Dallas-Makerspace/ThrICE-Access-Control/README

All schematics and circuit board designs are licensed under a Creative Commons Attribution-ShareAlike 3.0 Unported License.
