Dallas-Makerspace/ThrICE-Access-Control/threshold_control_device_smd.brd

## EAGLE design threshold_control_device_smd.brd (2012-08-05)

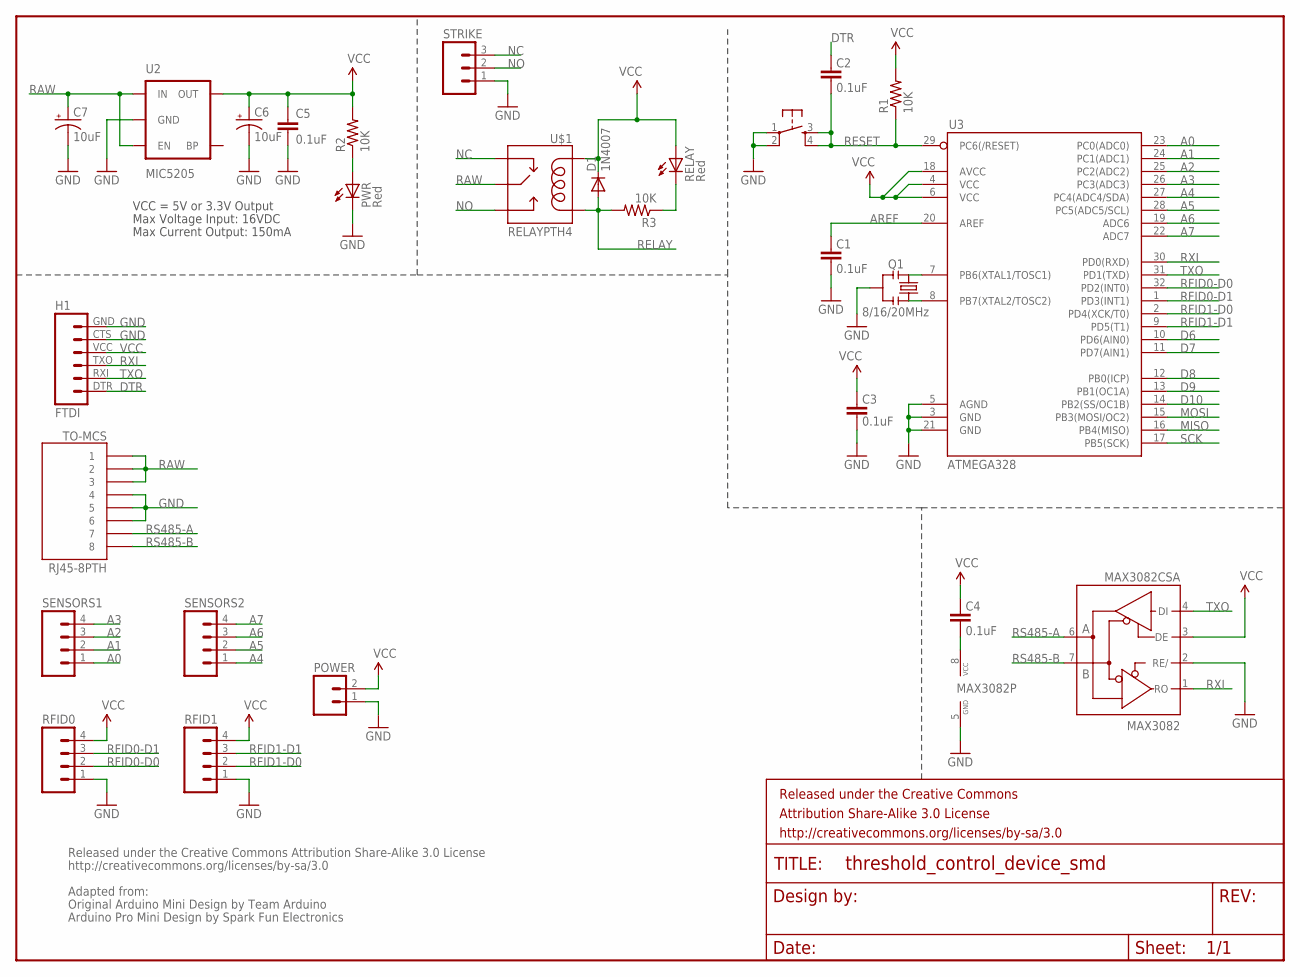
[picture p1: schematic threshold_control_device_smd.sch]

Parts:
C1, C2, C3, C4, C5: 0.1uF; 0402-CAP
C6, C7: 10uF; EIA3216
D1: 1N4007; SMA-DIODE
FRAME1: FRAME-LETTER; CREATIVE_COMMONS
H1: FTDI; FTDI_BASIC
MAX3082: MAX3082CSA; SO08
POWER: M023.5MM; SCREWTERMINAL-3.5MM-2
PWR: Red; LED-0603
Q1: 8/16/20MHz; RESONATOR-SMD
R1, R2, R3: 10K; 0402-RES
RELAY: Red; LED-0603
RESET: Reset; TACTILE_SWITCH_SMD
RFID0, RFID1: M04SCREW; SCREWTERMINAL-3.5MM-4
SENSORS1, SENSORS2: M04SCREW; SCREWTERMINAL-3.5MM-4
STRIKE: M03SCREW; SCREWTERMINAL-3.5MM-3
TO-MCS: RJ45-8PTH; RJ45-8
U2: MIC5205; SOT23-5
U3: ATMEGA328; TQFP32-08
U$1: RELAYPTH4; RELAY-JZC

Connections:
A0: SENSORS1.1, U3.23 (PC0(ADC0))
A1: SENSORS1.2, U3.24 (PC1(ADC1))
A2: SENSORS1.3, U3.25 (PC2(ADC2))
A3: SENSORS1.4, U3.26 (PC3(ADC3))
A4: SENSORS2.1, U3.27 (PC4(ADC4/SDA))
A5: SENSORS2.2, U3.28 (PC5(ADC5/SCL))
A6: SENSORS2.3, U3.19 (ADC6)
A7: SENSORS2.4, U3.22 (ADC7)
AREF: C1.2, U3.20 (AREF)
D6: U3.10 (PD6(AIN0))
D7: U3.11 (PD7(AIN1))
D8: U3.12 (PB0(ICP))
D9: U3.13 (PB1(OC1A))
D10: U3.14 (PB2(SS/OC1B))
DTR: C2.2, H1.DTR (1)
GND: C1.1, C3.1, C5.2, C6.C (-), C7.C (-), H1.CTS (5), H1.GND (6), MAX3082.2 (RE/), MAX3082.5 (GND), POWER.1, PWR.C, Q1.2, RESET.1, RESET.2, RFID0.1, RFID1.1, STRIKE.1, TO-MCS.4, TO-MCS.5, TO-MCS.6, U2.2 (GND), U3.3 (GND), U3.5 (AGND), U3.21 (GND)
MISO: U3.16 (PB4(MISO))
MOSI: U3.15 (PB3(MOSI/OC2))
unnamed: Q1.1, U3.8 (PB7(XTAL2/TOSC2))
unnamed: Q1.3, U3.7 (PB6(XTAL1/TOSC1))
unnamed: C4.1, MAX3082.8 (VCC)
unnamed: R3.1, RELAY.C
unnamed: PWR.A, R2.1
NC: STRIKE.3, U$1.2 (NC)
NO: STRIKE.2, U$1.3 (NO)
RAW: C7.A (+), TO-MCS.1, TO-MCS.2, TO-MCS.3, U2.1 (IN), U2.3 (EN), U$1.4 (MAIN)
RELAY: D1.A, R3.2, U$1.1 (COIL2)
RESET: C2.1, R1.1, RESET.3, RESET.4, U3.29 (PC6(/RESET))
RFID0-D0: RFID0.2, U3.32 (PD2(INT0))
RFID0-D1: RFID0.3, U3.1 (PD3(INT1))
RFID1-D0: RFID1.2, U3.2 (PD4(XCK/T0))
RFID1-D1: RFID1.3, U3.9 (PD5(T1))
RS485-A: MAX3082.6 (A), TO-MCS.7
RS485-B: MAX3082.7 (B), TO-MCS.8
RXI: H1.TXO (3), MAX3082.1 (RO), U3.30 (PD0(RXD))
SCK: U3.17 (PB5(SCK))
TXO: H1.RXI (2), MAX3082.4 (DI), U3.31 (PD1(TXD))
VCC: C3.2, C4.2, C5.1, C6.A (+), D1.C, H1.VCC (4), MAX3082.3 (DE), POWER.2, R1.2, R2.2, RELAY.A, RFID0.4, RFID1.4, U2.5 (OUT), U3.4 (VCC), U3.6 (VCC), U3.18 (AVCC), U$1.5 (COIL1)

Notes on the sheet:
Max Voltage Input: 16VDC
Max Current Output: 150mA
VCC = 5V or 3.3V Output
Released under the Creative Commons Attribution Share-Alike 3.0 License
http://creativecommons.org/licenses/by-sa/3.0
Original Arduino Mini Design by Team Arduino
Arduino Pro Mini Design by Spark Fun Electronics
Adapted from:

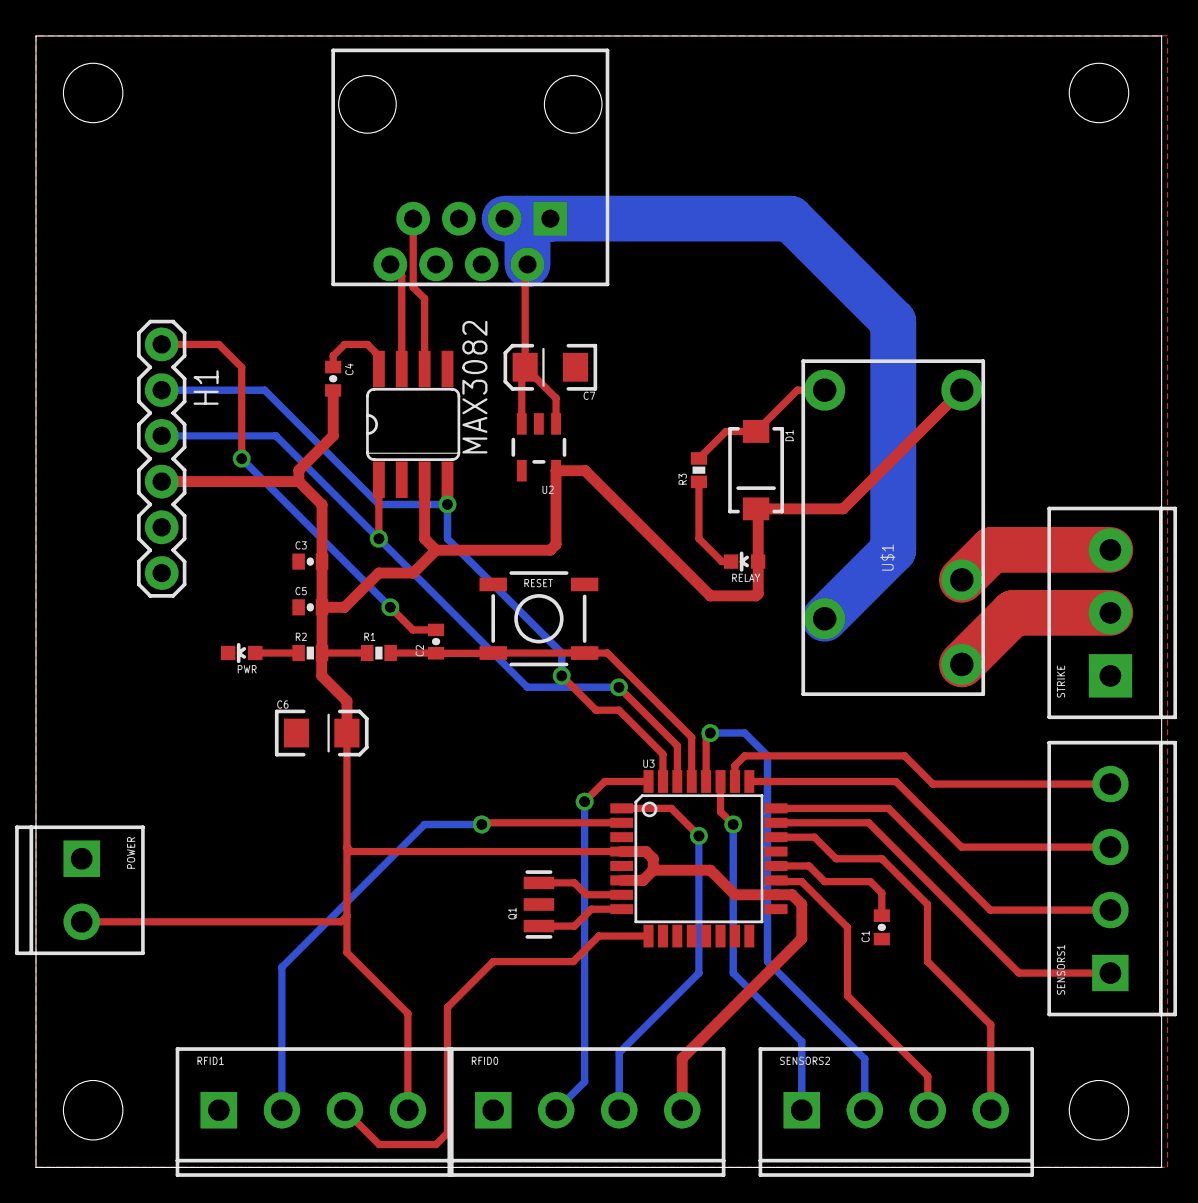
[picture p2: board threshold_control_device_smd.brd from above]

Board: 2 copper layers, 62.5 x 62.9 mm, 32 parts (0 on the bottom side), 30 nets.

Other parts of the board:
U$2, U$3, U$4, U$5: STAND-OFF
