Dallas-Makerspace/ThrICE-Access-Control/(commit log)

2011-06-26 First commit, HIA schematic and board mostly done.
    [human_interface_arduino.brd, human_interface_arduino.sch]
2011-06-26 Removed reset switch, and ICSP header. Connected the Arduino to the buzzer. Added 5v for the motion detector. Redid the board layout, added 0.07" traces for the 12v strike.
    [human_interface_arduino.brd, human_interface_arduino.sch]
2011-06-27 Minor route changes.
    [human_interface_arduino.brd]
2011-06-27 Started work on MCA.
    [master_control_arduino.sch]
2011-06-27 Simplified the HIA some more. HIA can now use the ID-12 or Parallax's RFID reader. HIA board has been rearranged and a new board created for the ID-12.
    [human_interface_arduino.brd, human_interface_arduino.sch]
2011-07-04 HIA mostly done, just need to tweak the routes for the keypad header. Started work on the MCA shield (master_control_shield).
    [human_interface_arduino.brd, human_interface_arduino.sch, master_control_shield.brd, master_control_shield.sch]
2011-07-04 HIA complete, only a handful of traces remain on the bottom layer so it might be possible to make the board single layer (with the bottom being just ground.
    [human_interface_arduino.brd]
2011-07-04 Added power supply circuitry, based on the designs from the open-access-control project. http://code.google.com/p/open-access-control/
    [master_control_shield.brd, master_control_shield.sch]
2011-08-04 HIA is now single sided, so it should be easier to fab in house. You'll just need a 0 Ohm resistor.
    [human_interface_arduino.brd, human_interface_arduino.sch]
2011-08-05 Still single sided for the HIA, but now you don't need to use a jumper (or 0 Ohm resistor).
    [human_interface_arduino.brd, human_interface_arduino.sch]
2011-08-05 Minor tweaks.
    [human_interface_arduino.brd]
2011-08-07 Renamed system components. HIA is now TCD (Threshold Control Device) and MCA is now MCS (Master Control System).
    [master_control_system.sch, threshold_control_device.brd, threshold_control_device.sch]
2011-08-07 Schematic for the MCS is mostly done. The board is too large for me to design it with the free version of Eagle, which will set things back a bit. Moved the power regulation off board to save space.
    [master_control_shield.brd, master_control_shield.sch, master_control_system.sch, power_control_subsystem.brd, power_control_subsystem.sch]
2011-08-10 Modified the TCD to fit the new design idea (all sensors polled via serial). I'll have to redo the board later so that the sensors are connected to the ADC.
    [threshold_control_device.brd, threshold_control_device.sch]
2011-08-10 Basic idea I had for a TCD "filter" to protect the MCS from attack.
    [tcd-filter.brd, tcd-filter.sch]
2011-08-10 Complete rework of the design to allow for expansion boards.
    [master_control_shield.sch, threshold_control_device.brd, threshold_control_device.sch]
2011-08-11 More changes, renamed the shield to the mega_shield because the new version will work with a standard Arduino.
    [master_control_mega_shield.brd, master_control_mega_shield.sch, master_control_shield.sch, threshold_control_device.brd, threshold_control_device.sch]
2011-08-11 Master Control Shield is basically done. It has 6 jumpers but it is technically single layer.
    [master_control_shield.brd, master_control_shield.sch, threshold_control_device.brd, threshold_control_device.sch]
2011-08-11 MCS and MCS expansion are done, maybe.
    [master_control_shield.brd, master_control_shield.sch, mcs_expansion.brd, mcs_expansion.sch]
2011-08-13 Added DMS logo to the boards.
    [master_control_shield.brd, mcs_expansion.brd, threshold_control_device.brd, threshold_control_device.sch]
2011-08-13 There's probably an award for people too stupid to use a transistor properly.
    [threshold_control_device.brd, threshold_control_device.sch]
2011-08-13 Moved the ID-12 breakout to it's own file.
    [ID-12_breakout.brd, ID-12_breakout.sch, threshold_control_device.brd, threshold_control_device.sch]
2011-08-13 Minor changes, mostly cosmetic.
    [ID-12_breakout.brd, master_control_shield.brd, mcs_expansion.brd, threshold_control_device.brd]
2011-08-13 More minor tweaks.
    [master_control_shield.brd, mcs_expansion.brd]
2011-08-18 Started work on rs485 variant.
    [master_control_shield.brd, master_control_shield.sch, master_control_shield_v1.brd, master_control_shield_v1.sch, mcs_expansion.brd, mcs_expansion.sch, threshold_control_device.brd, threshold_control_device.sch]
2011-08-18 RS485 variant completed, still needs to be tested.
    [master_control_shield.brd, master_control_shield.sch, mcs_expansion.brd, mcs_expansion.sch, threshold_control_device.brd, threshold_control_device.sch]
2011-08-18 Moved RS232 variant to it's own folder.
    [master_control_mega_shield.brd, master_control_mega_shield.sch, master_control_shield.brd, master_control_shield.sch, mcs_expansion.brd, mcs_expansion.sch, threshold_control_device.brd, threshold_control_device.sch]
2011-08-18 Minor tweaks to the RS485 variant.
    [master_control_shield.brd, master_control_shield.sch, mcs_expansion.brd, mcs_expansion.sch]
2011-08-18 I'm not sure why git is saying the file was renamed (it wasn't). Just doing some more minor tweaks to make things look nice.
    [master_control_shield.sch, master_control_shield_v1.brd, master_control_shield_v1.sch, threshold_control_device.brd, threshold_control_device.sch]
2011-08-18 Rounded corners, because it looks cool.
    [ID-12_breakout.brd, master_control_shield.brd, mcs_expansion.brd, threshold_control_device.brd]
2011-08-18 Minor tweaks after running a design rule check.
    [master_control_shield.sch, mcs_expansion.brd, mcs_expansion.sch]
2011-08-18 All 12v traces are now 86 mils for each relay (at least), 150 mils for the backbone link and 100 mils on the TCD.
    [ID-12_breakout.brd, master_control_shield.brd, mcs_expansion.brd, threshold_control_device.brd]
2011-09-03 Modified MCS to use the TPIC6B595 power logic shift register, as the original shift register could not source enough current to activate the relays.
    [master_control_shield.brd, master_control_shield.sch]
2011-09-03 Playing around with an SMD version of the TCD.
    [threshold_control_device_smd.brd, threshold_control_device_smd.sch]
2011-09-10 MCS Expansion board needs to be redone due to the new shift register, and the change made to how the boards are inter-connected.
    [mcs_expansion.brd, mcs_expansion.sch]
2011-09-19 MCS Expansion redone to use the Power Shift Register. ID-12 modified to have slightly larger traces, to make it easier to etch. TCD modified to have a resistor for each color on the RGB led. Power Co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
    [ID-12_breakout.brd, master_control_shield.brd, mcs_expansion.brd, mcs_expansion.sch, power_control_subsystem.brd, threshold_control_device.brd, threshold_control_device.sch]
2011-09-19 Switched to a lower poly version of the logo.
    [ID-12_breakout.brd, master_control_shield.brd, mcs_expansion.brd, threshold_control_device.brd]
2011-10-07 Minor tweaks for production.
    [ID-12_breakout.brd, master_control_shield.brd, mcs_expansion.brd, threshold_control_device.brd]
2011-10-30 Minor cosmetic tweaks to the TCD.
    [threshold_control_device.brd, threshold_control_device.sch]
2012-08-05 Scratch that, lets try this all over again...
    [master_control_mega_shield.brd, master_control_mega_shield.sch, master_control_shield.brd, master_control_shield.sch, mcs_expansion.brd, mcs_expansion.sch, tcd-filter.brd, tcd-filter.sch]
